rayaanatif/BinarX-Rot/3mf-and-stl/BinarX_Rot_All_Parts.3mf

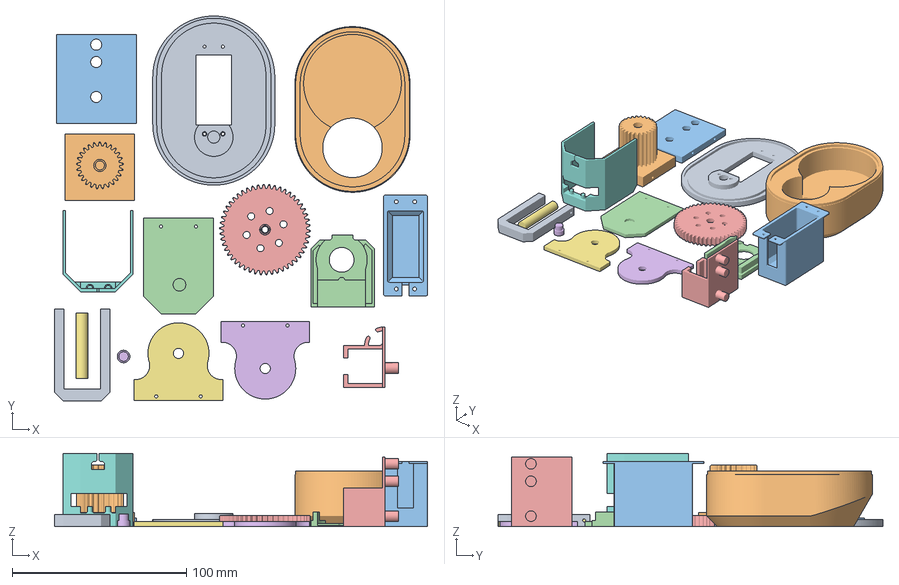
[picture p3: CAD file, 2026-10-20]
3mf-and-stl/BinarX_Rot_All_Parts.3mf
214.0 x 220.8 x 42.0 mm
binarxrotallparts.stl_12
binarxrotallparts.stl_4
binarxrotallparts.stl_5
binarxrotallparts.stl_8
binarxrotallparts.stl_13
binarxrotallparts.stl_7
binarxrotallparts.stl_2
binarxrotallparts.stl_6
binarxrotallparts.stl_1
binarxrotallparts.stl_11
binarxrotallparts.stl_9
binarxrotallparts.stl_3
binarxrotallparts.stl_15
binarxrotallparts.stl_10
binarxrotallparts.stl_14
