rayaanatif/BinarX-Rot/parts/COTSAntennaBracket.stl

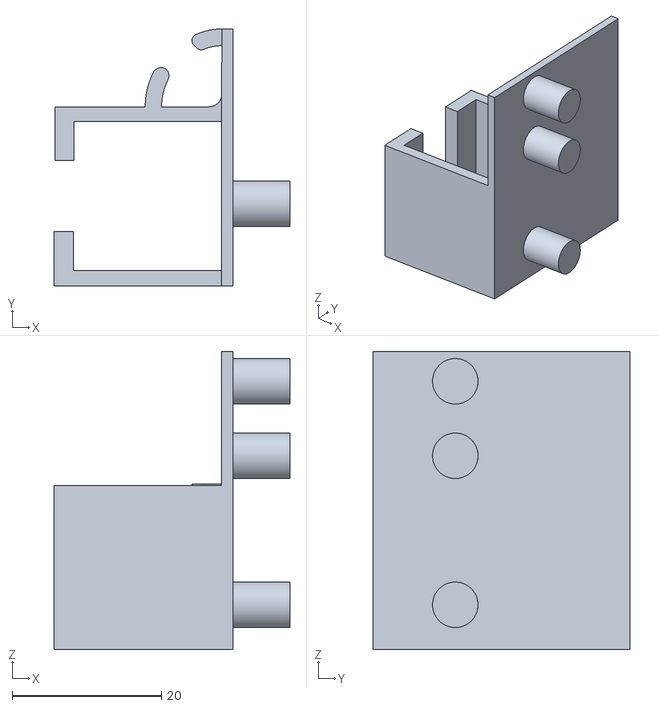
[picture p4: CAD file, 2026-10-20]
parts/COTSAntennaBracket.stl
31.7 x 34.5 x 40.0
