rayaanatif/BinarX-Rot/parts/AzProtectionCover.stl

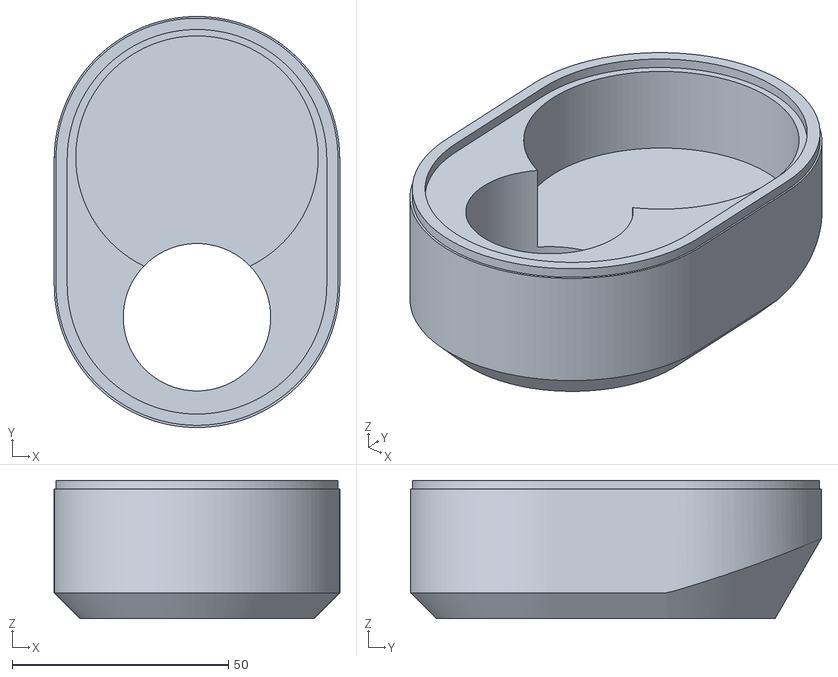
[picture p5: CAD file, 2026-10-20]
parts/AzProtectionCover.stl
66.0 x 95.0 x 32.0
