rayaanatif/BinarX-Rot/parts/RearPlate.stl

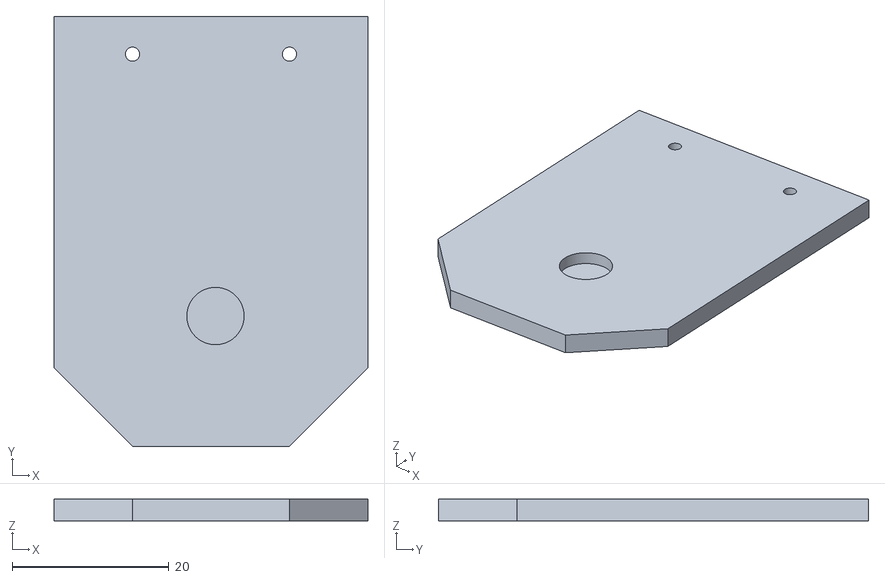
[picture p6: CAD file, 2026-10-20]
parts/RearPlate.stl
40.0 x 54.8 x 2.80
