rayaanatif/BinarX-Rot/parts/ServoBrace.stl

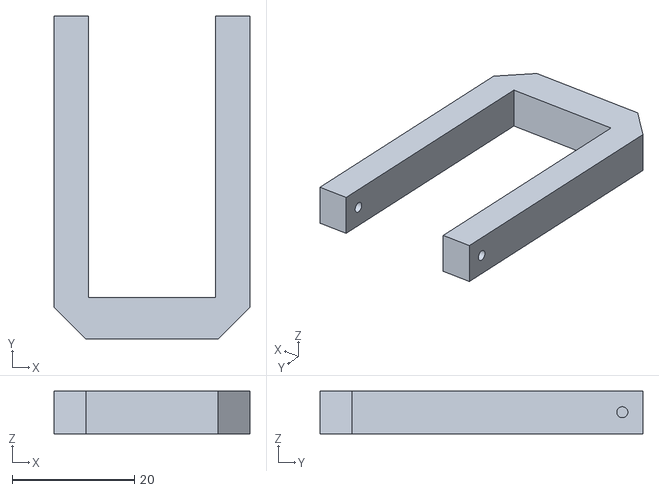
[picture p7: CAD file, 2026-10-20]
parts/ServoBrace.stl
32.0 x 52.8 x 7.00
