rayaanatif/BinarX-Rot/parts/AzMount.stl

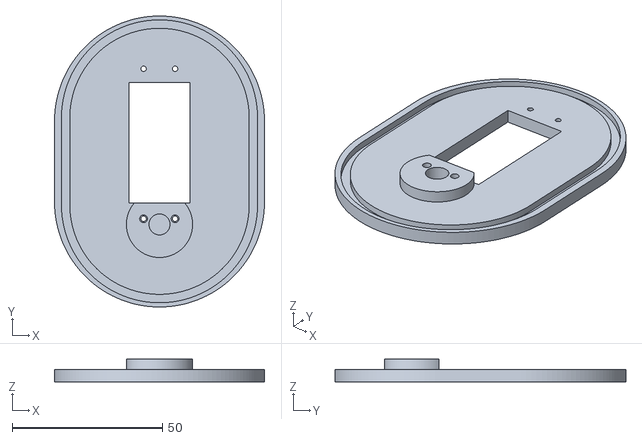
[picture p8: CAD file, 2026-10-20]
parts/AzMount.stl
70.0 x 97.0 x 7.50
