rayaanatif/BinarX-Rot/parts/ElArmSidePlate_x2.stl

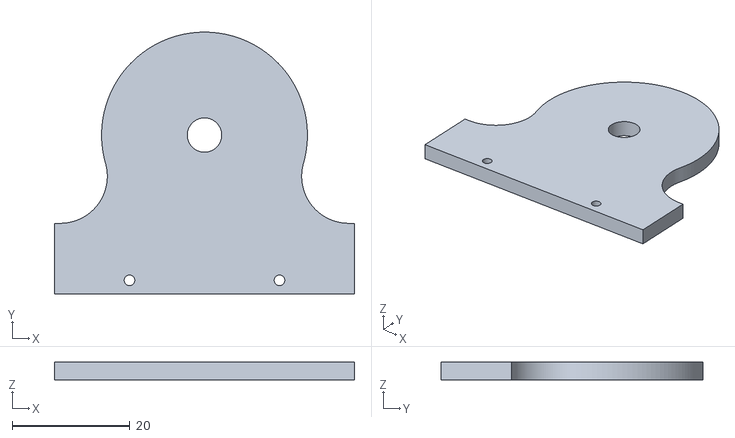
[picture p9: CAD file, 2026-10-20]
parts/ElArmSidePlate_x2.stl
51.0 x 44.5 x 3.00
