rayaanatif/BinarX-Rot/parts/SmallGearBase.stl

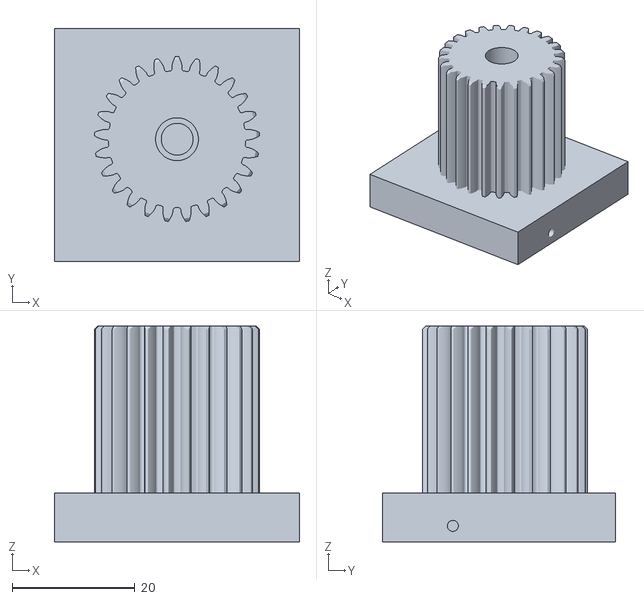
[picture p10: CAD file, 2026-10-20]
parts/SmallGearBase.stl
40.0 x 38.1 x 35.2
