rayaanatif/BinarX-Rot/parts/ElRotatorPin.stl

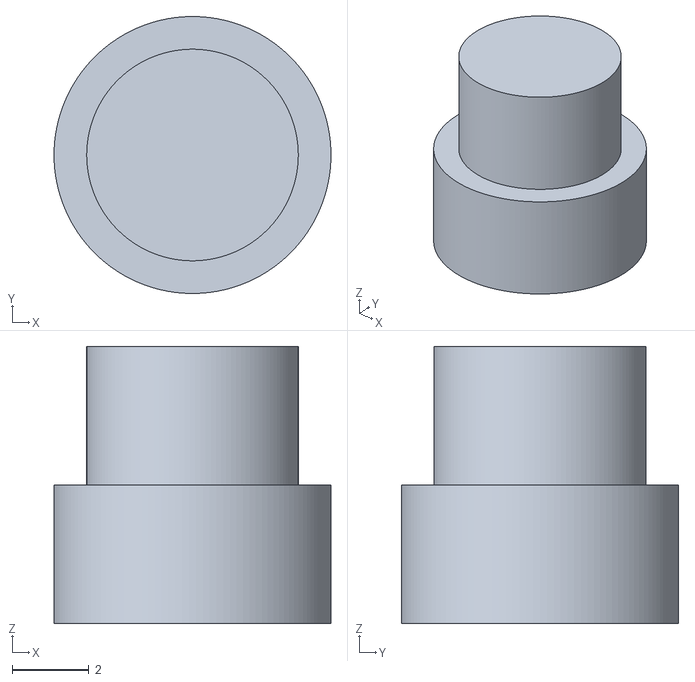
[picture p11: CAD file, 2026-10-20]
parts/ElRotatorPin.stl
7.20 x 7.20 x 7.20
