rayaanatif/BinarX-Rot/parts/AzServoCasing.stl

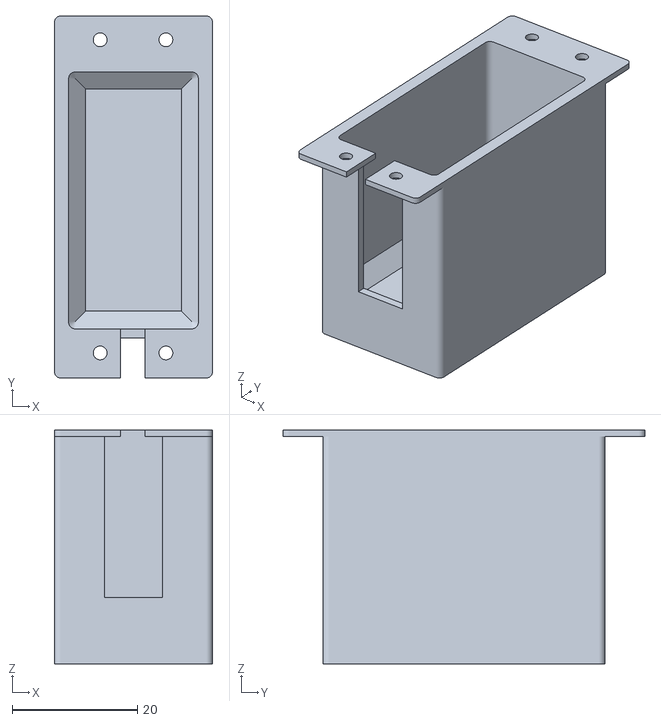
[picture p12: CAD file, 2026-10-20]
parts/AzServoCasing.stl
25.2 x 57.8 x 37.3
