rayaanatif/BinarX-Rot/parts/ElRod.stl

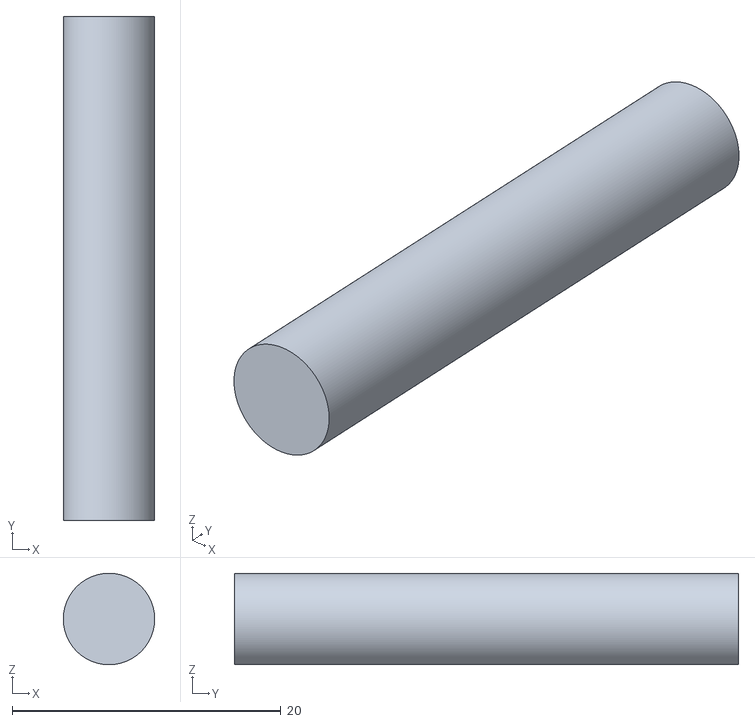
[picture p13: CAD file, 2026-10-20]
parts/ElRod.stl
6.80 x 37.5 x 6.80
