rayaanatif/BinarX-Rot/parts/ElServoFrontPlate.stl

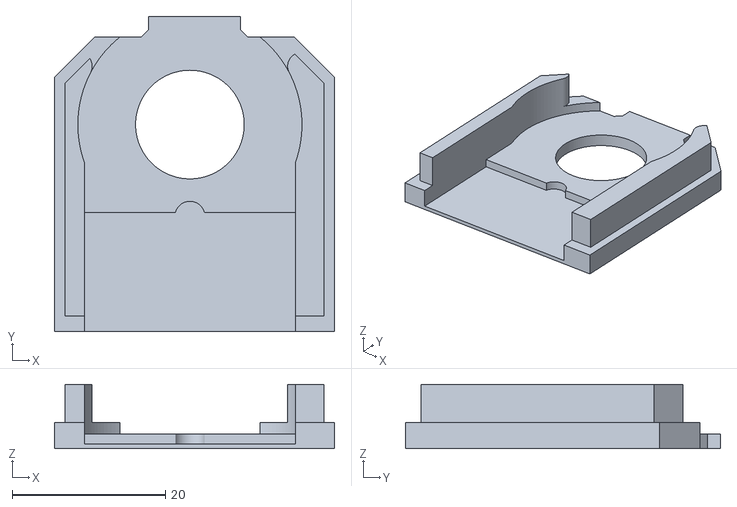
[picture p14: CAD file, 2026-10-20]
parts/ElServoFrontPlate.stl
36.6 x 41.2 x 8.40
