rayaanatif/BinarX-Rot/parts/ElServoCover.stl

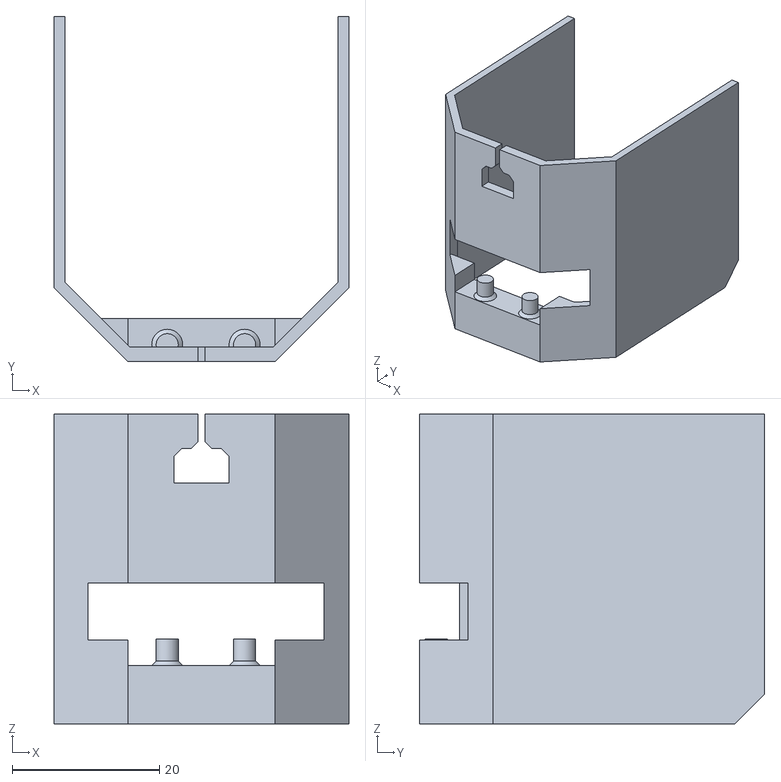
[picture p15: CAD file, 2026-10-20]
parts/ElServoCover.stl
40.0 x 46.8 x 42.0
