rayaanatif/BinarX-Rot/parts/AntennaMountPlate.stl

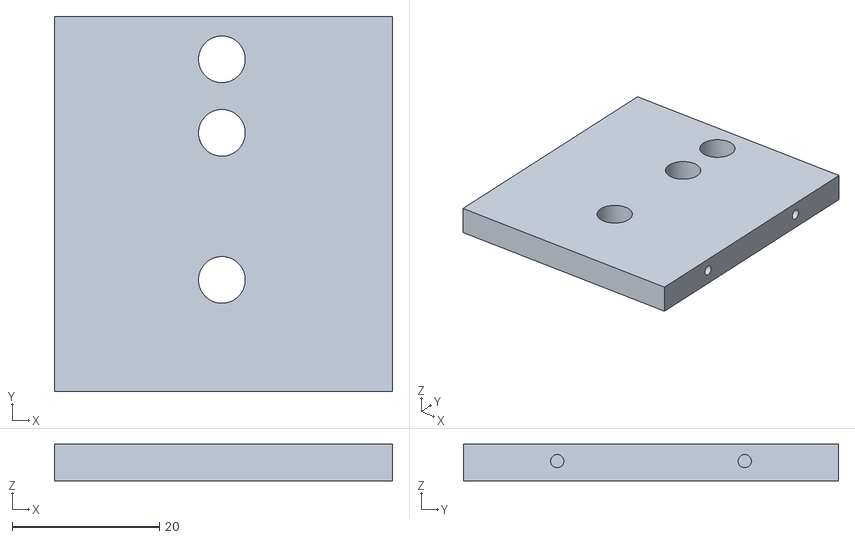
[picture p16: CAD file, 2026-10-20]
parts/AntennaMountPlate.stl
46.0 x 51.0 x 5.00
