rayaanatif/BinarX-Rot/parts/LargeGear.stl

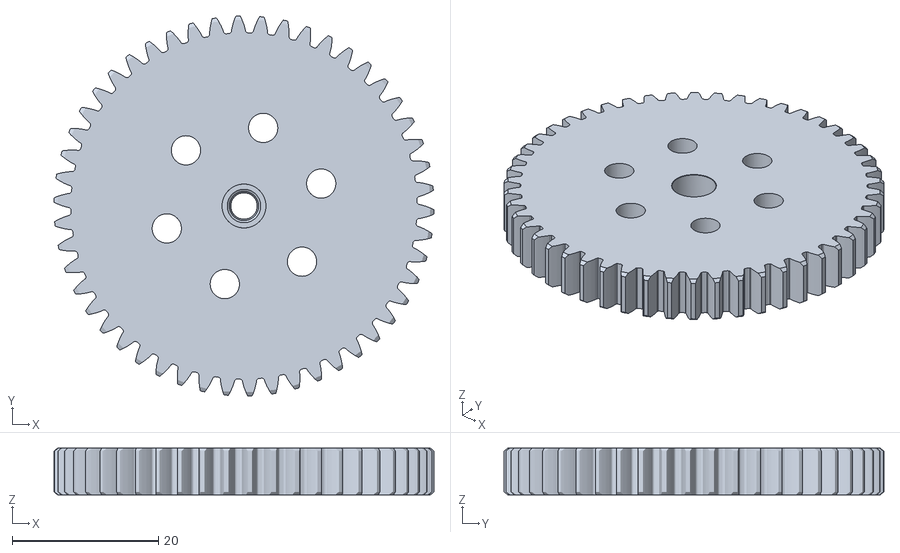
[picture p17: CAD file, 2026-10-20]
parts/LargeGear.stl
52.0 x 52.0 x 6.40
