rayaanatif/BinarX-Rot/(list of files, cad)

Other CAD files:
3mf-and-stl/BinarX_Rot_All_Parts.stl
