rayaanatif/BinarX-Rot/(commit log)

2026-10-20 Add BinarX rotator printable parts
    Individual STL files named to match the build guide, plus combined 3MF and STL.
    [AntennaMountPlate.stl, AzMount.stl, AzProtectionCover.stl, AzServoCasing.stl, BinarX_Rot_All_Parts.3mf, BinarX_Rot_All_Parts.stl, COTSAntennaBracket.stl, ElArmSidePlate_x2.stl]
2026-10-20 Add build guide and split licences
    Adds the build guide (docs/), the MIT licence for the Arduino code, and
    licence notes for the hardware (CERN-OHL-S-2.0) and the guide (CC BY-SA 4.0).
